SriranganS/Water-Surface-Trash-Collector/Pool Testing/Images/Isometric Angle.jpg

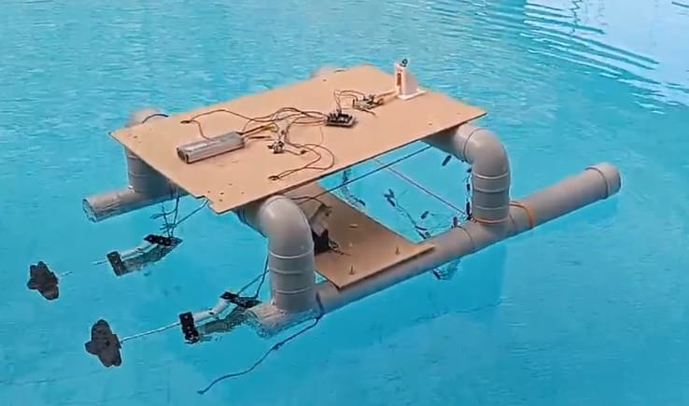
Pool Testing/Images/Isometric Angle.jpg
