SriranganS/Water-Surface-Trash-Collector/Pool Testing/Images/Floating.jpg

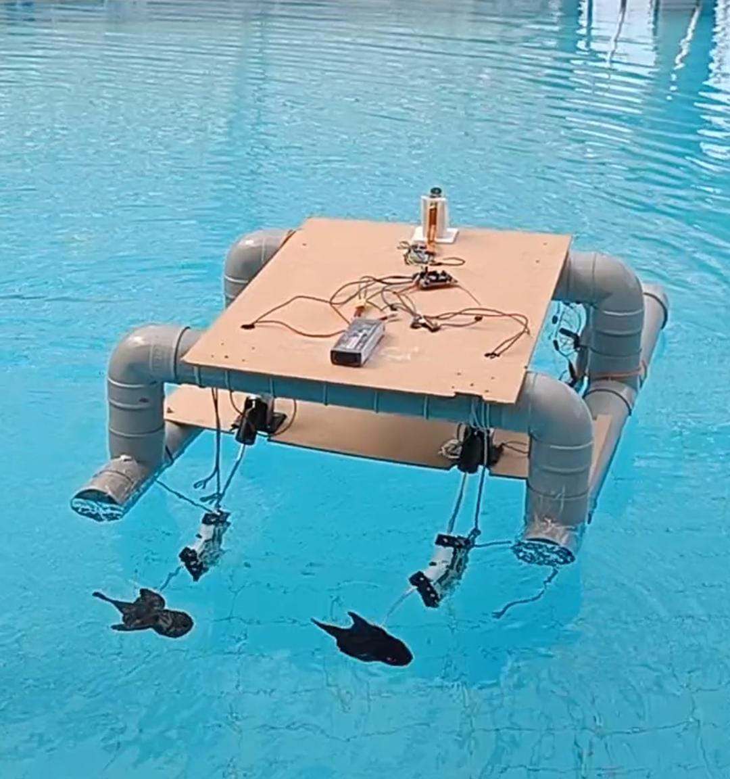
Pool Testing/Images/Floating.jpg
