SriranganS/Water-Surface-Trash-Collector/README.md

# Water-Surface-Trash-Collector
This project is part of the ES 408: Mechatronics course. Our objective is to make a boat with autonomous abilities that could be utilised to pick up trash floating in the water.
