SriranganS/Water-Surface-Trash-Collector/Presentation 1.pdf

# Water Surface Trash Collector

Hrishikesh Birje
Mihika Desai
Srirangan S

Mechanical Engineering
Indian Institute of Technology, Gandhinagar

# Problem

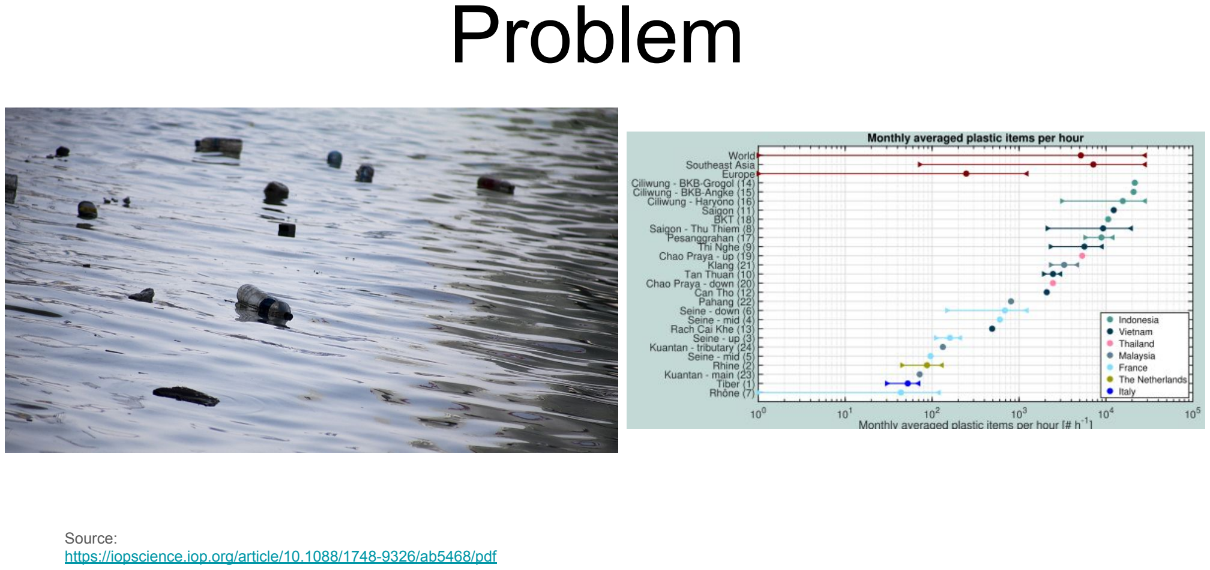
[picture p4: page 2]

8-10 metric tonnes enter the ocean every year.

Source:
https://iopscience.iop.org/article/10.1088/1748-9326/ab5468/pdf

## Design

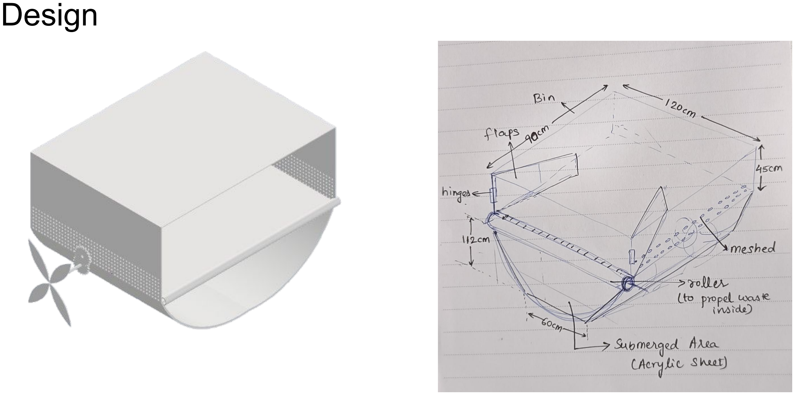
[picture p5: page 3]

## Details

- Material - Acrylic Sheet (density = 1180 kg/m3)
- Controller - Raspberry pi
- Assumed - Volume of Water displaced = 243 Litres
- We kept the height of the immersed area as a variable. On equating the Buoyant force with the Weight of the immersed body, we concluded the height to be 1.12 meters.
- Motors - 12V BLDC Motors
- Propellers (Diameter = 20 cm) - 500 rpm
- Gear - To elevate the motor altitude for waterproofing

## Electronic Circuitry

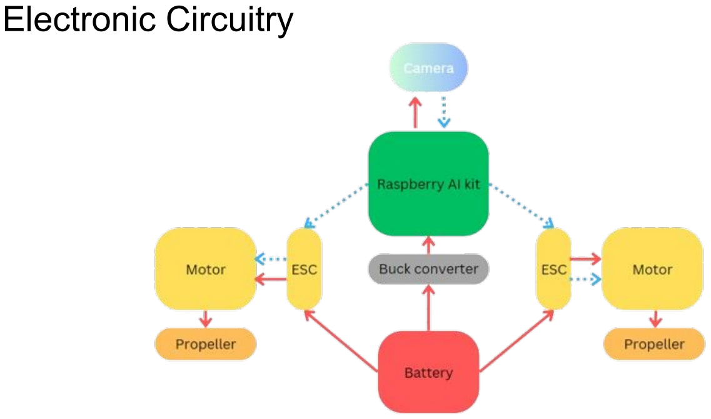
[picture p6: page 5]
