SriranganS/Water-Surface-Trash-Collector/Buoyancy Calculations for Design 2/Buoyancy Calculations 1.jpg

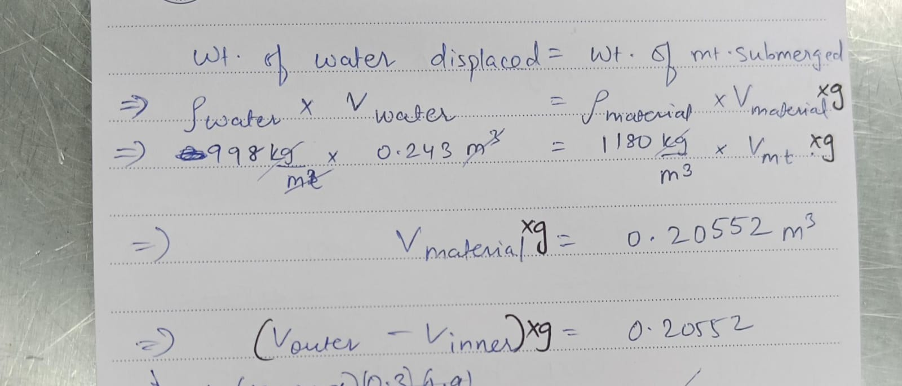
Buoyancy Calculations for Design 2/Buoyancy Calculations 1.jpg
