SriranganS/Water-Surface-Trash-Collector/Buoyancy Calculations for Design 2/Buoyancy Calculations 2.jpg

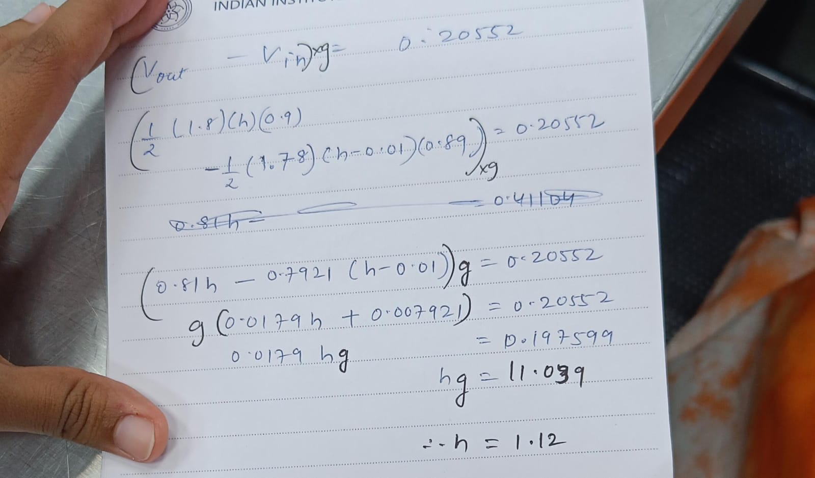
Buoyancy Calculations for Design 2/Buoyancy Calculations 2.jpg
