SriranganS/Water-Surface-Trash-Collector/MotorPropeller Connections/Images/Connection.jpg

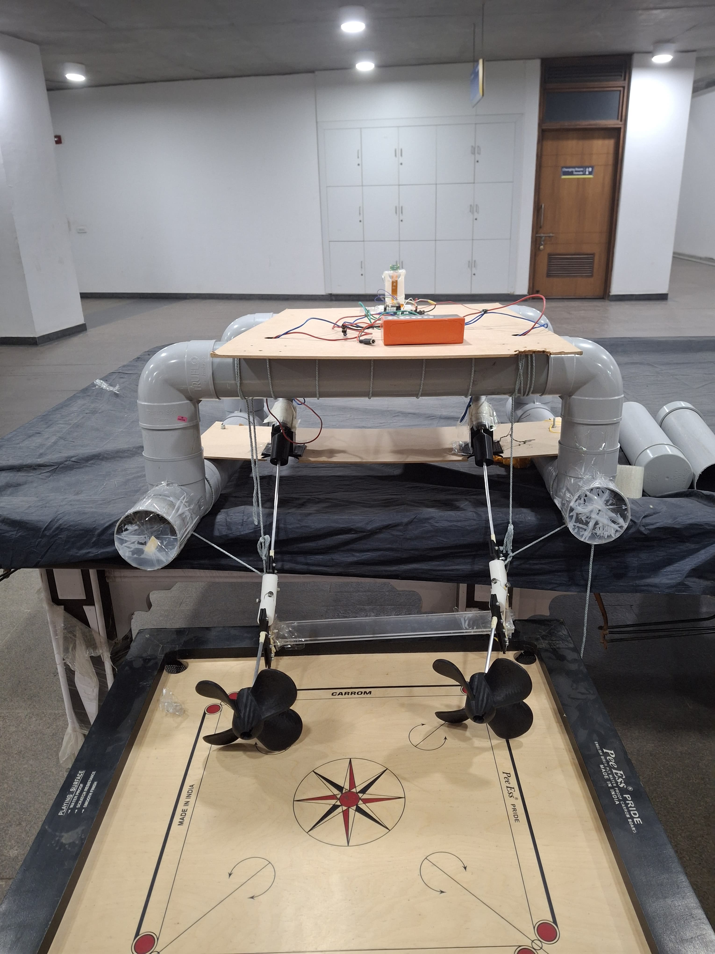
MotorPropeller Connections/Images/Connection.jpg
