SriranganS/Water-Surface-Trash-Collector/Updated Design/MainBody.SLDASM

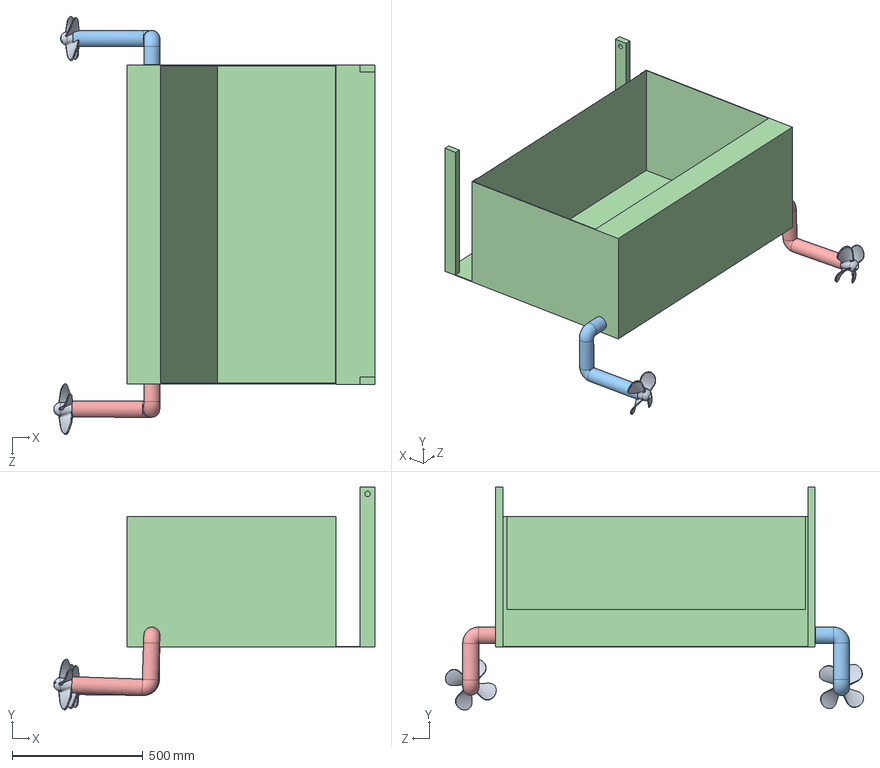
[picture p10: CAD file, 2024-10-14]
Updated Design/MainBody.SLDASM
1228.2 x 853.2 x 1600.4 mm
TubeRight
tefon dock
TubeLeft
Motor x 2
Prop 1 x 2
