SriranganS/Water-Surface-Trash-Collector/MotorPropeller Connections/CAD Models/U Joints/U Joint Attempts/Orient1.SLDASM

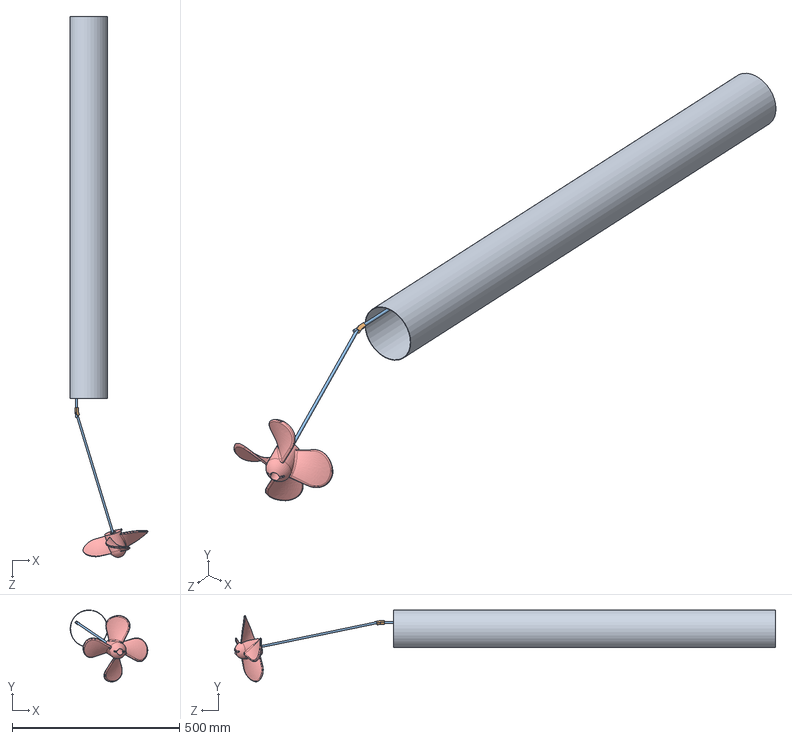
[picture p11: CAD file, 2024-11-22]
MotorPropeller Connections/CAD Models/U Joints/U Joint Attempts/Orient1.SLDASM
232.3 x 215.2 x 1619.7 mm
Prop 1
PropClos
Shaf x 2
Ujoint
Pip
