SriranganS/Water-Surface-Trash-Collector/Updated Design/Conveyer Belt.SLDASM

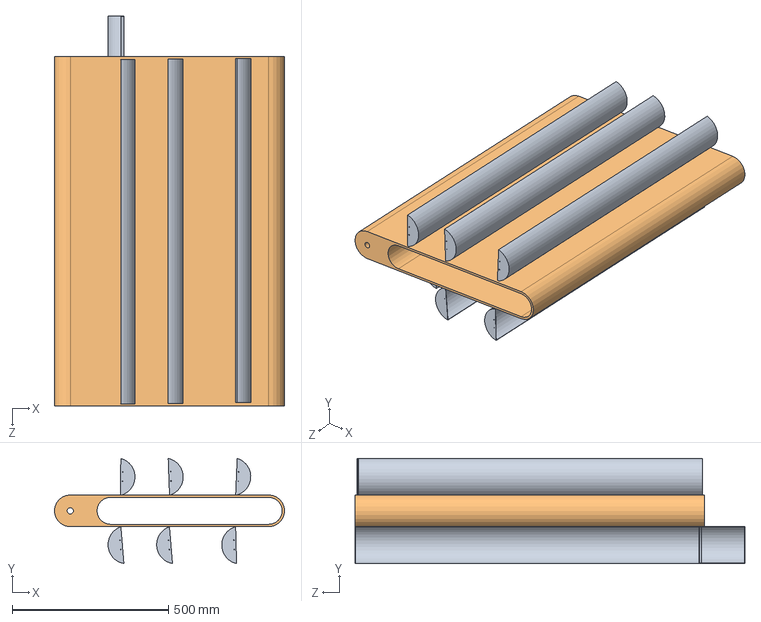
[picture p12: CAD file, 2024-10-14]
Updated Design/Conveyer Belt.SLDASM
736.6 x 337.0 x 1248.0 mm
belt
blade 300mm x 6
