SriranganS/Water-Surface-Trash-Collector/CAD Model for Final Prototype/MainBody.SLDASM

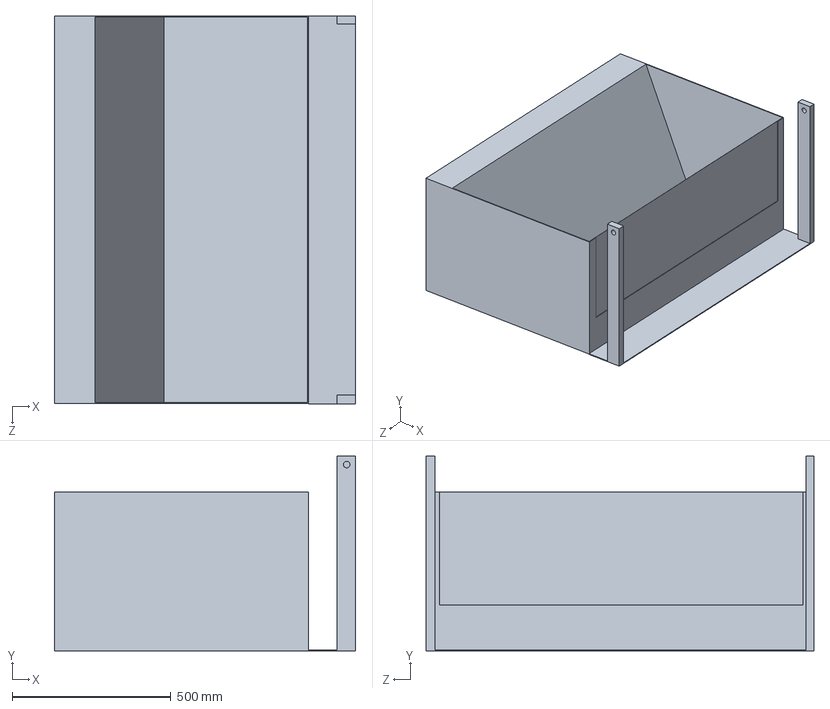
[picture p13: CAD file, 2024-11-22]
CAD Model for Final Prototype/MainBody.SLDASM
948.3 x 612.6 x 1221.2 mm
