SriranganS/Water-Surface-Trash-Collector/MotorPropeller Connections/CAD Models/U Joints/U Joint Attempts/ASSY_BERG_UJ3_U-JOINT_0250 SHAFT.sldasm

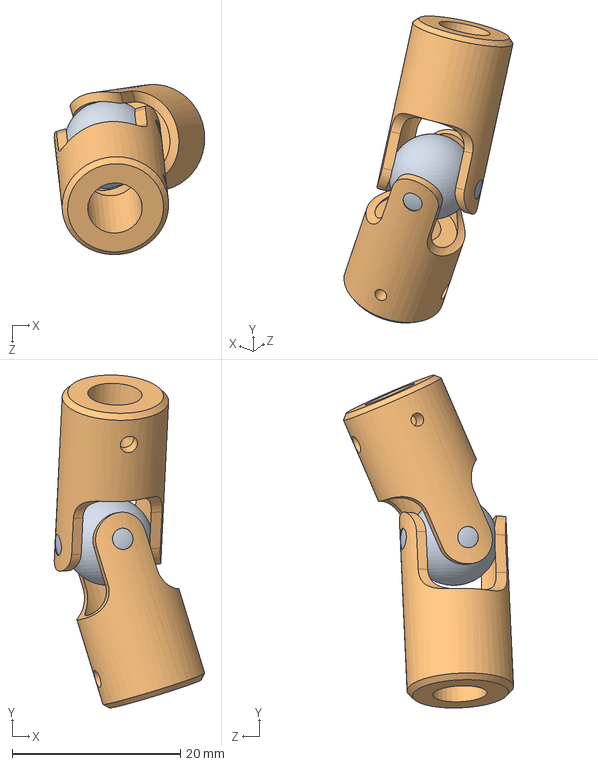
[picture p14: CAD file, 2024-11-22]
MotorPropeller Connections/CAD Models/U Joints/U Joint Attempts/ASSY_BERG_UJ3_U-JOINT_0250 SHAFT.sldasm
17.9 x 39.6 x 20.3 mm
UJ-3_YOKE x 2
UJ-3_BALL
