SriranganS/Water-Surface-Trash-Collector/Updated Design/FinalAssembly.SLDASM

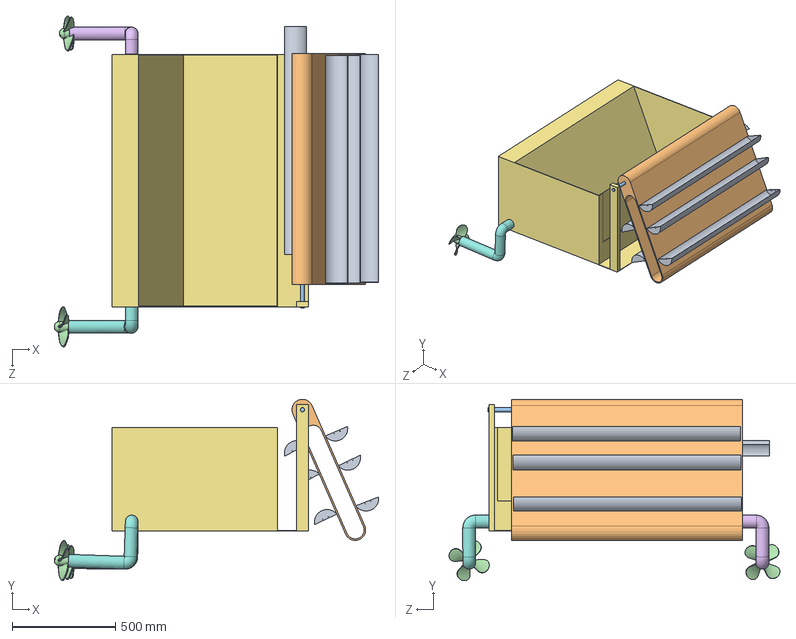
[picture p15: CAD file, 2024-10-14]
Updated Design/FinalAssembly.SLDASM
1568.6 x 877.3 x 1600.4 mm
TubeRight
tefon dock
TubeLeft
Motor x 2
Prop 1 x 2
Shaft
belt
blade 300mm x 6
