SriranganS/Water-Surface-Trash-Collector/CAD Model for Final Prototype/PresentCAD.SLDASM

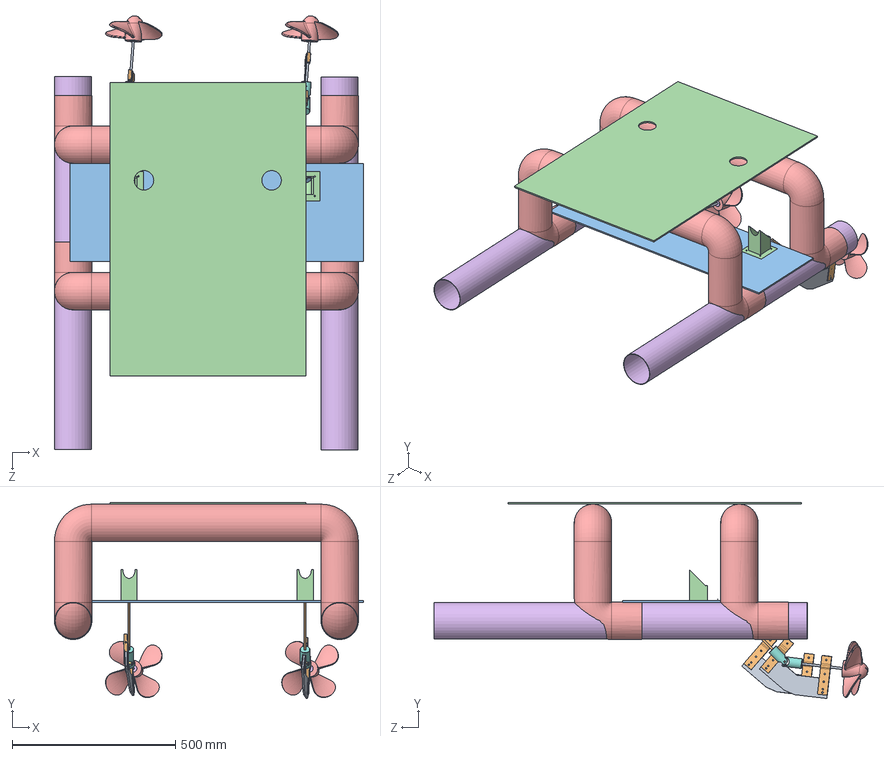
[picture p16: CAD file, 2024-11-22]
CAD Model for Final Prototype/PresentCAD.SLDASM
947.6 x 600.9 x 1330.0 mm
BottomPipe x 2
RectPipe x 2
MDF
LowerMDF
ShaftLong x 2
ShaftShort x 2
Joint B x 4
Plus x 2
PropClos x 2
Prop 1 x 2
mountmotor x 2
motormount_part2 x 2
shaft_angle_fixer x 8
plat2 x 2
