SriranganS/Water-Surface-Trash-Collector/CAD Model for Final Prototype/ShaftFix.SLDASM

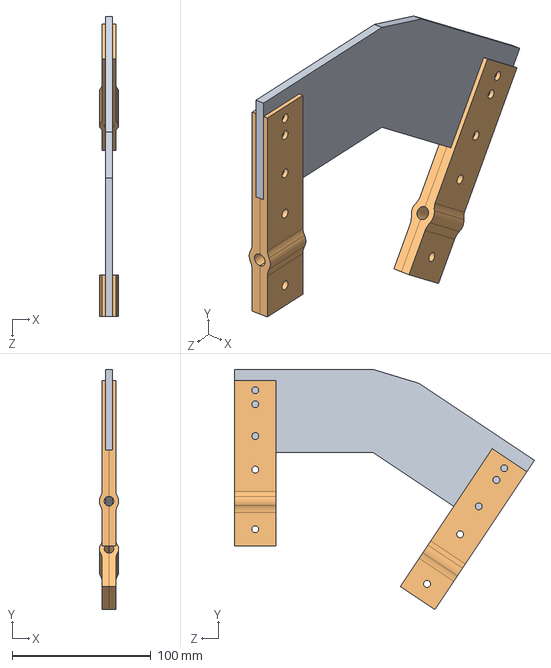
[picture p17: CAD file, 2024-11-22]
CAD Model for Final Prototype/ShaftFix.SLDASM
13.9 x 173.3 x 216.5 mm
shaft_angle_fixer x 4
plat2
