SriranganS/Water-Surface-Trash-Collector/CAD Model for Final Prototype/mountmotor_assembly.SLDASM

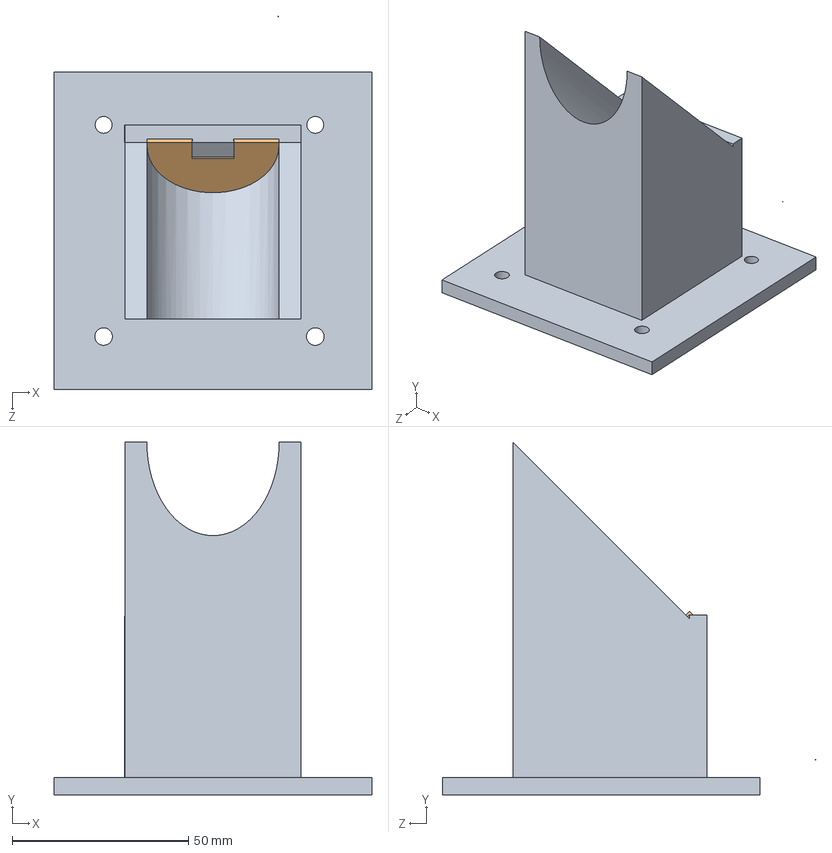
[picture p18: CAD file, 2024-11-22]
CAD Model for Final Prototype/mountmotor_assembly.SLDASM
90.0 x 100.0 x 105.7 mm
motormount_part2
mountmotor
