SriranganS/Water-Surface-Trash-Collector/CAD Model for Final Prototype/BottomPipe.SLDPRT

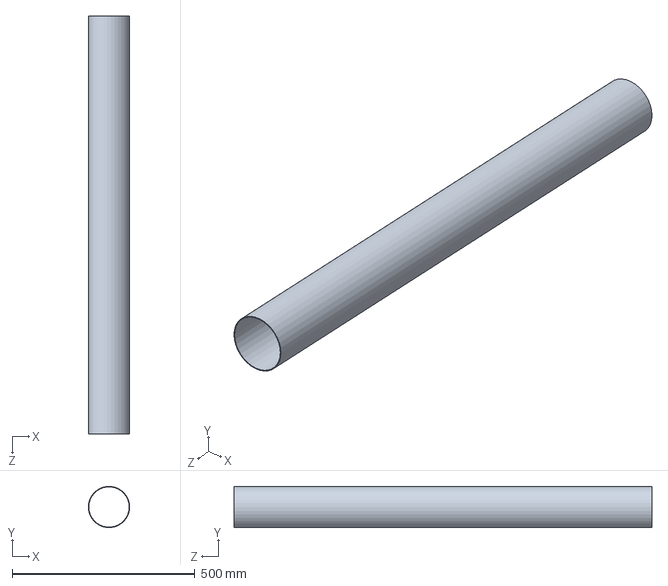
[picture p19: CAD file, 2024-11-22]
CAD Model for Final Prototype/BottomPipe.SLDPRT
113.0 x 112.5 x 1143.0 mm
