SriranganS/Water-Surface-Trash-Collector/MotorPropeller Connections/CAD Models/Assembly/ShaftShort.SLDPRT

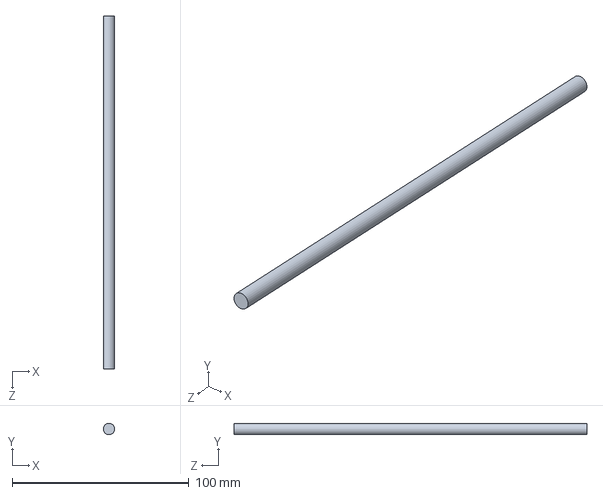
[picture p20: CAD file, 2024-11-22]
MotorPropeller Connections/CAD Models/Assembly/ShaftShort.SLDPRT
6.50 x 6.49 x 200.0 mm
