SriranganS/Water-Surface-Trash-Collector/MotorPropeller Connections/CAD Models/Coupler Attempts/DoubCoup.STL

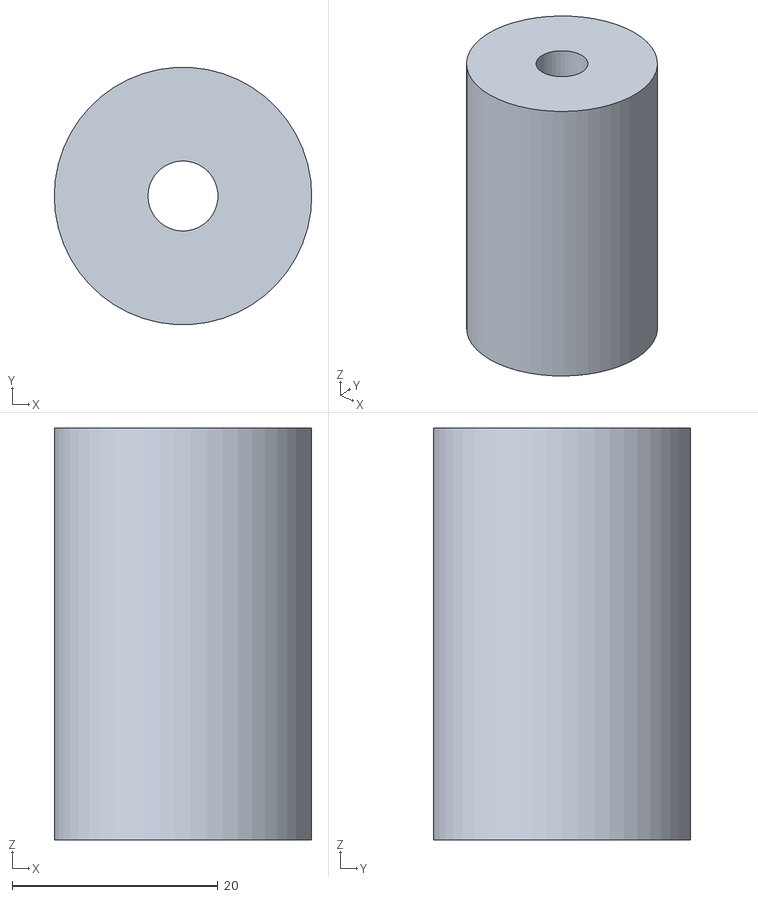
[picture p21: CAD file, 2024-11-22]
MotorPropeller Connections/CAD Models/Coupler Attempts/DoubCoup.STL
25.0 x 25.0 x 40.0
