SriranganS/Water-Surface-Trash-Collector/MotorPropeller Connections/CAD Models/MotorMount/motormount_part2.STL

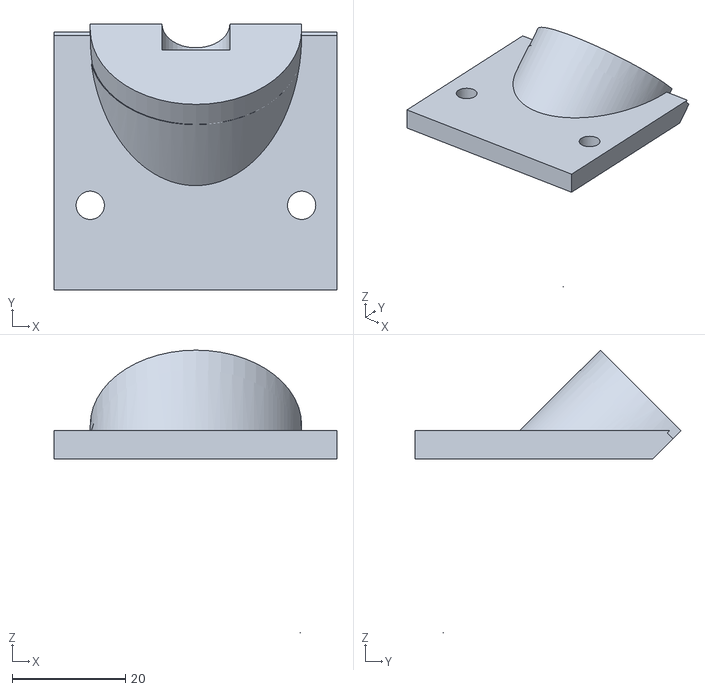
[picture p22: CAD file, 2024-11-22]
MotorPropeller Connections/CAD Models/MotorMount/motormount_part2.STL
50.0 x 47.1 x 50.0
