SriranganS/Water-Surface-Trash-Collector/MotorPropeller Connections/CAD Models/U Joints/U Joint Attempts/UJ-3_YOKE.sldprt

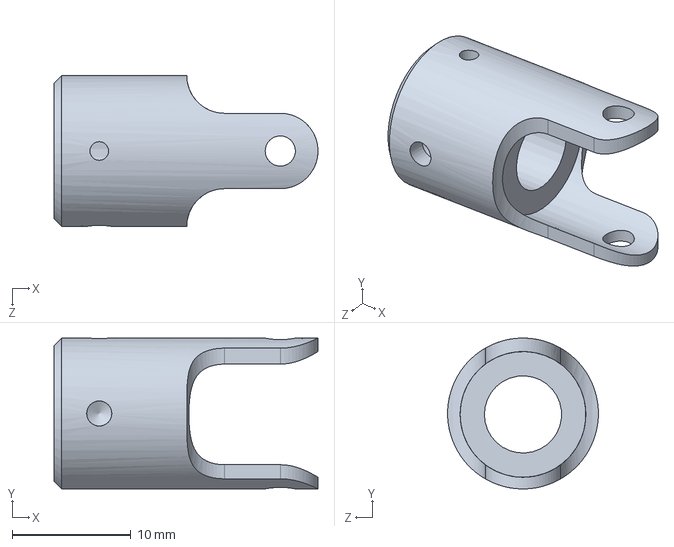
[picture p23: CAD file, 2024-11-22]
MotorPropeller Connections/CAD Models/U Joints/U Joint Attempts/UJ-3_YOKE.sldprt
22.2 x 12.7 x 12.7 mm
