SriranganS/Water-Surface-Trash-Collector/MotorPropeller Connections/CAD Models/U Joints/U Joint Final/Plus.SLDPRT

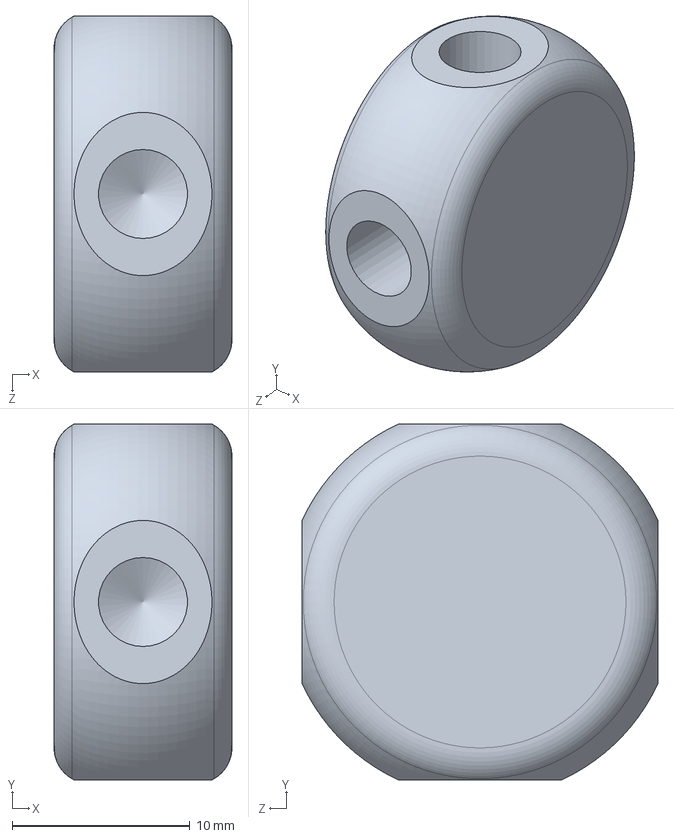
[picture p24: CAD file, 2024-11-22]
MotorPropeller Connections/CAD Models/U Joints/U Joint Final/Plus.SLDPRT
10.0 x 20.0 x 20.0 mm
