SriranganS/Water-Surface-Trash-Collector/U Joint Stabilisation/CAD/Catch.DXF

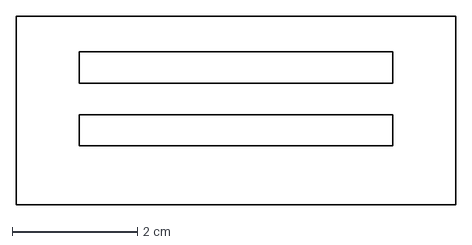
[picture p25: CAD file, 2024-11-22]
U Joint Stabilisation/CAD/Catch.DXF
7.00 x 3.00 cm
