SriranganS/Water-Surface-Trash-Collector/Updated Design/TubeLeft.SLDPRT

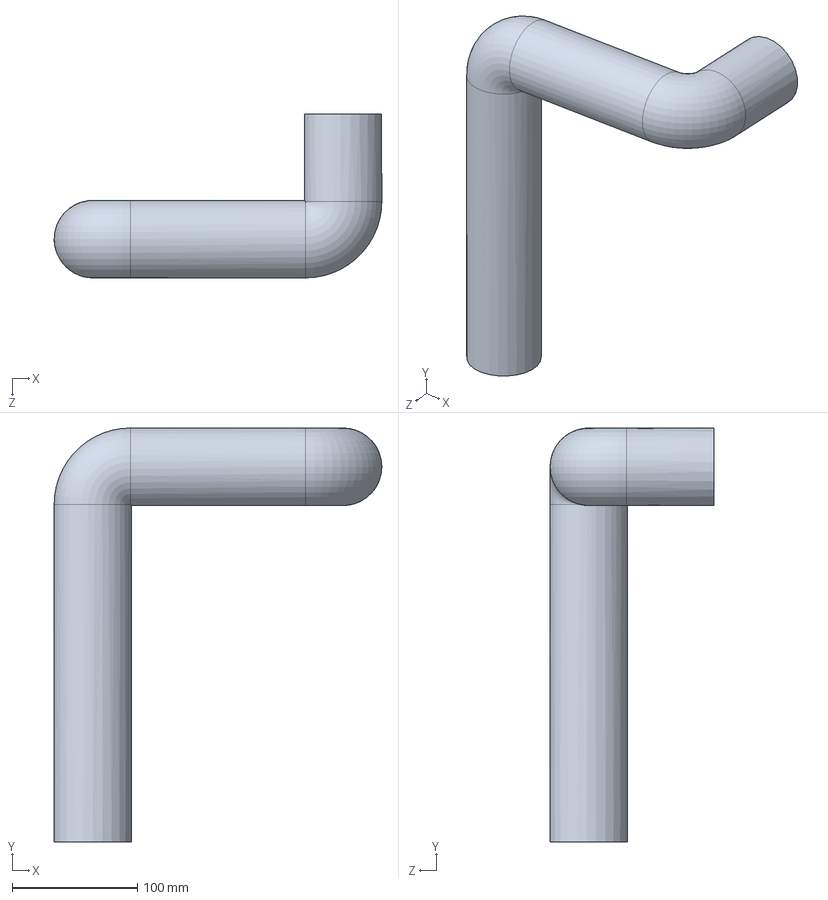
[picture p26: CAD file, 2024-10-14]
Updated Design/TubeLeft.SLDPRT
262.0 x 331.0 x 131.0 mm
