SriranganS/Water-Surface-Trash-Collector/Waterproofing - Universal Joints/CAD/UJointcover.STL

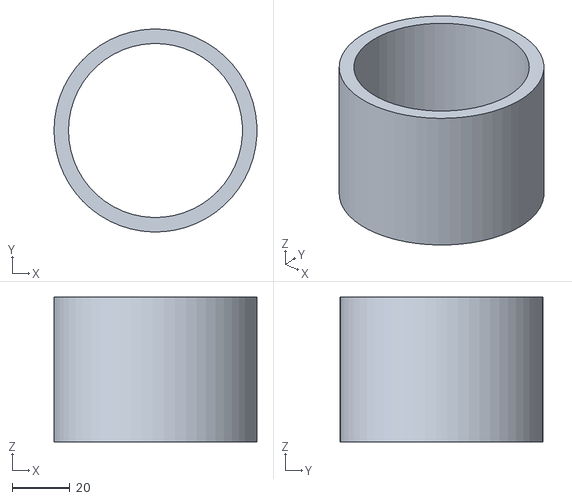
[picture p27: CAD file, 2024-11-22]
Waterproofing - Universal Joints/CAD/UJointcover.STL
70.0 x 70.0 x 50.0
