SriranganS/Water-Surface-Trash-Collector/Waterproofing Mechanism 1/LStand.STL

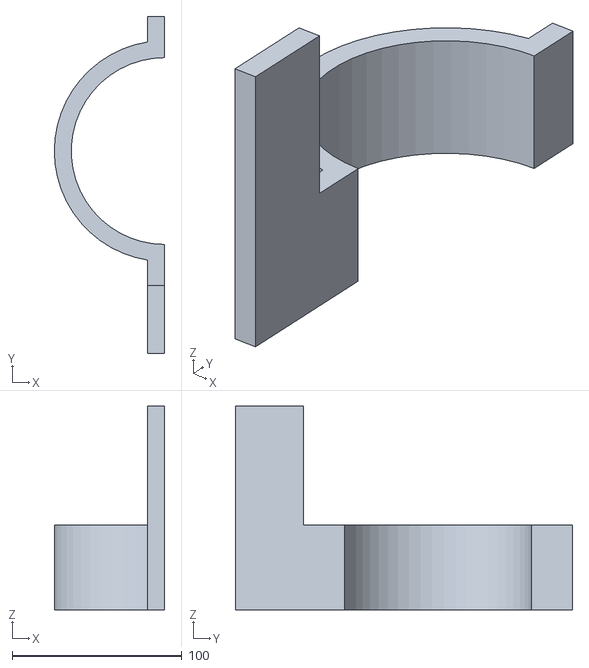
[picture p28: CAD file, 2024-11-22]
Waterproofing Mechanism 1/LStand.STL
65.0 x 198.5 x 120.0
