SriranganS/Water-Surface-Trash-Collector/CAD Model for Final Prototype/MDF.SLDPRT

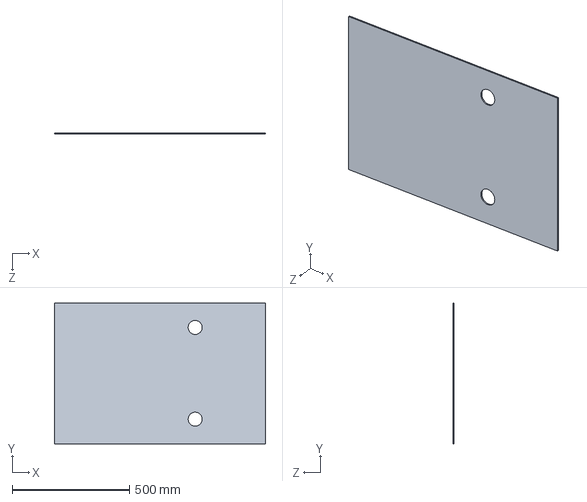
[picture p29: CAD file, 2024-11-22]
CAD Model for Final Prototype/MDF.SLDPRT
900.0 x 600.0 x 5.00 mm
