SriranganS/Water-Surface-Trash-Collector/MotorPropeller Connections/CAD Models/Assembly/ShaftLong.SLDPRT

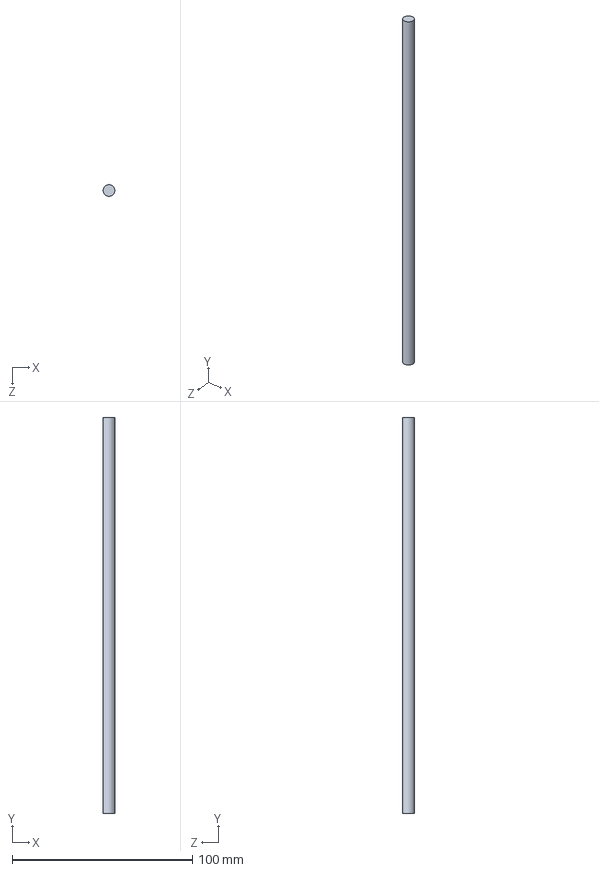
[picture p30: CAD file, 2024-11-22]
MotorPropeller Connections/CAD Models/Assembly/ShaftLong.SLDPRT
6.45 x 220.0 x 6.50 mm
