SriranganS/Water-Surface-Trash-Collector/MotorPropeller Connections/CAD Models/Coupler Attempts/SelfMadeCoupler.STL

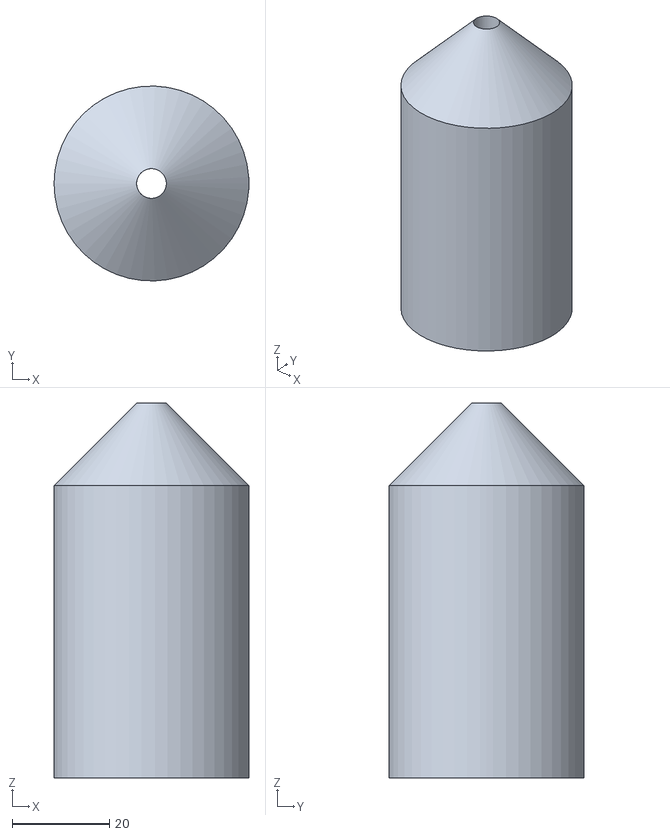
[picture p31: CAD file, 2024-11-22]
MotorPropeller Connections/CAD Models/Coupler Attempts/SelfMadeCoupler.STL
40.0 x 40.0 x 76.9
