SriranganS/Water-Surface-Trash-Collector/MotorPropeller Connections/CAD Models/MotorMount/mountmotor_new.STL

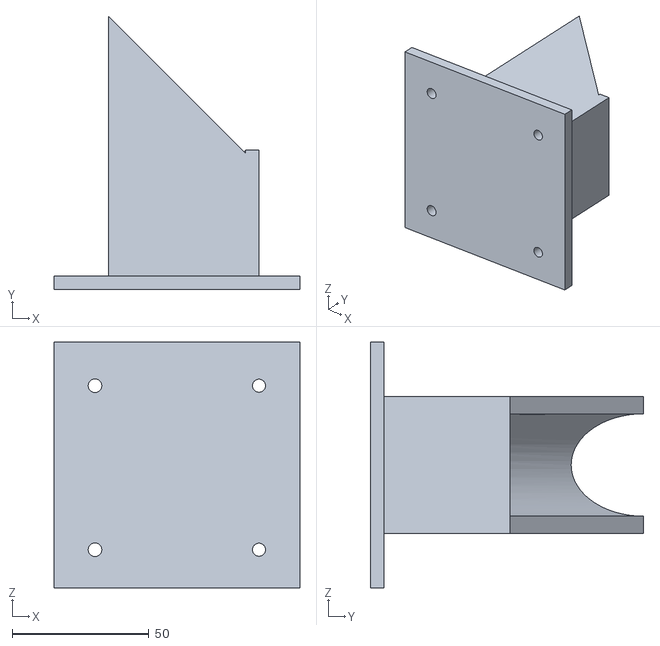
[picture p32: CAD file, 2024-11-22]
MotorPropeller Connections/CAD Models/MotorMount/mountmotor_new.STL
90.0 x 100.0 x 90.0
