SriranganS/Water-Surface-Trash-Collector/MotorPropeller Connections/CAD Models/U Joints/U Joint Attempts/Shaf.SLDPRT

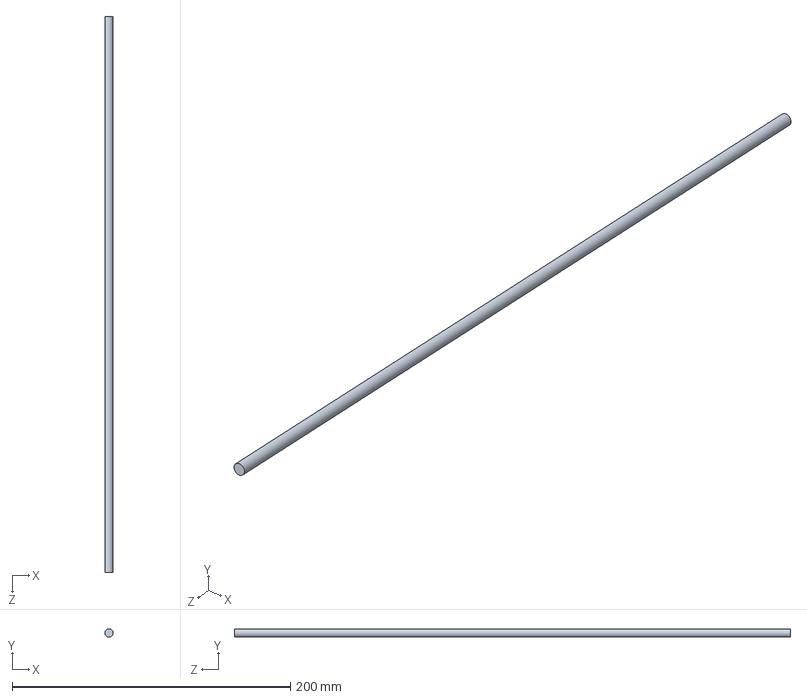
[picture p33: CAD file, 2024-11-22]
MotorPropeller Connections/CAD Models/U Joints/U Joint Attempts/Shaf.SLDPRT
6.00 x 6.00 x 400.0 mm
