SriranganS/Water-Surface-Trash-Collector/MotorPropeller Connections/CAD Models/U Joints/U Joint Final/Joint B.SLDPRT

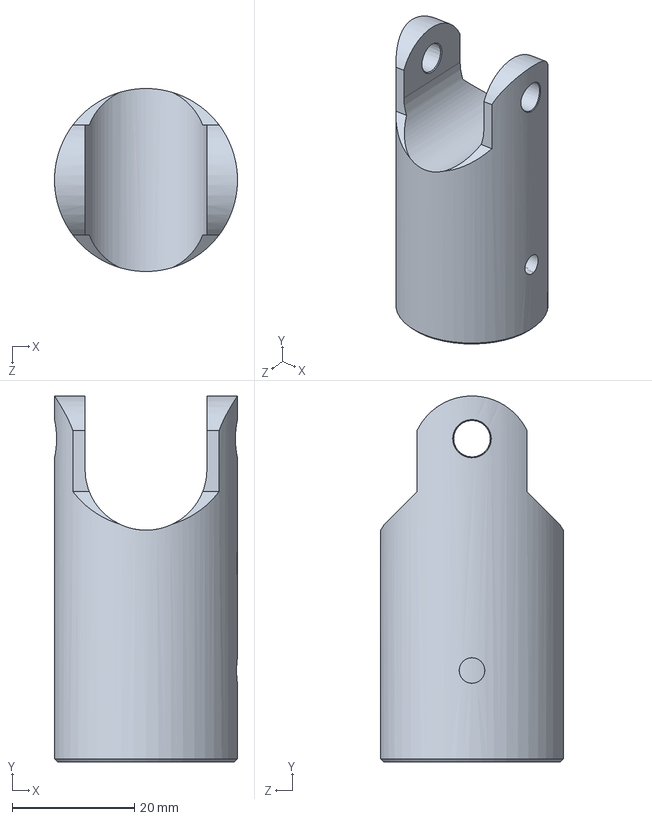
[picture p34: CAD file, 2024-11-22]
MotorPropeller Connections/CAD Models/U Joints/U Joint Final/Joint B.SLDPRT
30.0 x 60.0 x 30.0 mm
