SriranganS/Water-Surface-Trash-Collector/CAD Model for Final Prototype/Battery - Copy.SLDPRT

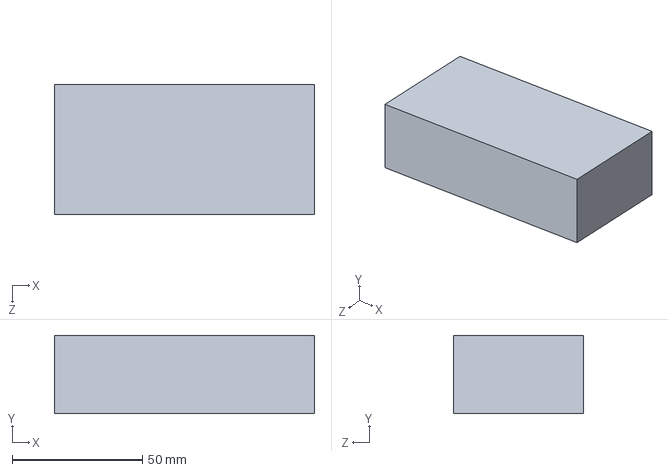
[picture p35: CAD file, 2024-11-22]
CAD Model for Final Prototype/Battery - Copy.SLDPRT
100.0 x 30.0 x 50.0 mm
