SriranganS/Water-Surface-Trash-Collector/MotorPropeller Connections/CAD Models/Coupler Attempts/flex coupler.STL

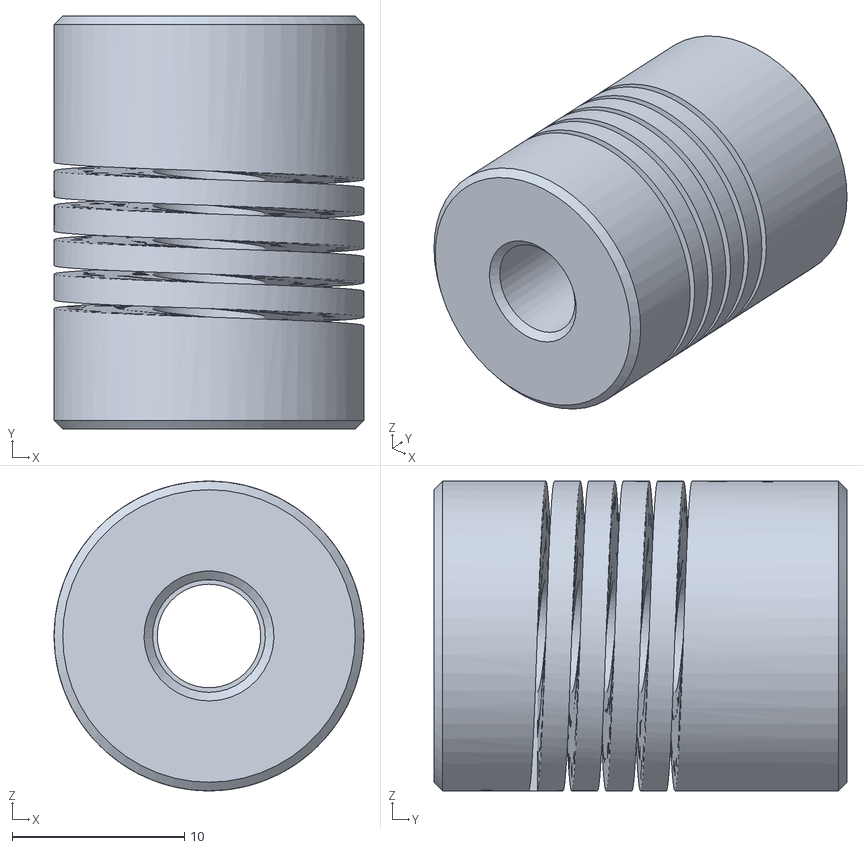
[picture p36: CAD file, 2024-11-22]
MotorPropeller Connections/CAD Models/Coupler Attempts/flex coupler.STL
18.0 x 24.0 x 18.0
