SriranganS/Water-Surface-Trash-Collector/Waterproofing Mechanism 1/gear.SLDPRT

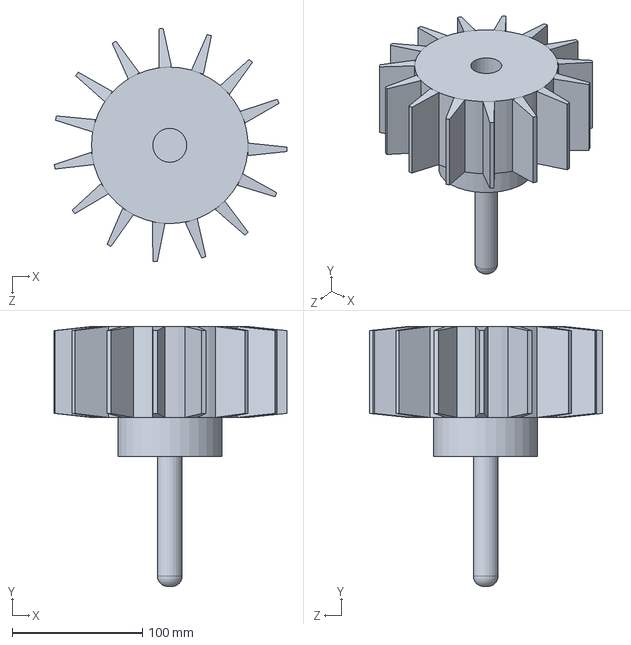
[picture p37: CAD file, 2024-11-22]
Waterproofing Mechanism 1/gear.SLDPRT
178.9 x 200.0 x 179.5 mm
