SriranganS/Water-Surface-Trash-Collector/CAD Model for Final Prototype/platf2.DXF

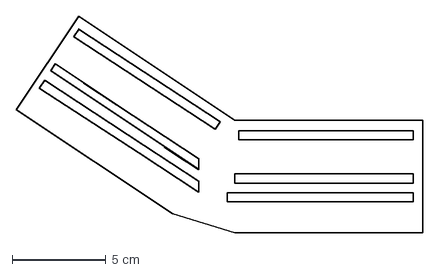
[picture p38: CAD file, 2024-11-22]
CAD Model for Final Prototype/platf2.DXF
21.6 x 11.5 cm
