SriranganS/Water-Surface-Trash-Collector/MotorPropeller Connections/CAD Models/Coupler Attempts/Shaft Coupler.STL

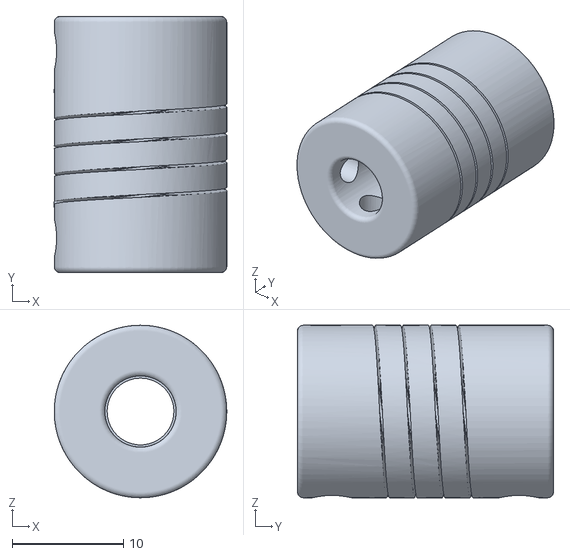
[picture p39: CAD file, 2024-11-22]
MotorPropeller Connections/CAD Models/Coupler Attempts/Shaft Coupler.STL
15.5 x 23.0 x 15.5
