SriranganS/Water-Surface-Trash-Collector/Waterproofing Mechanism 1/gearupper.SLDPRT

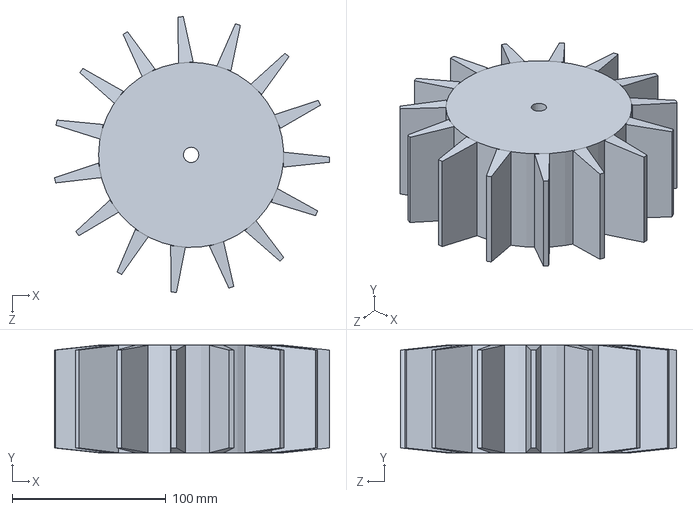
[picture p40: CAD file, 2024-11-22]
Waterproofing Mechanism 1/gearupper.SLDPRT
178.9 x 70.0 x 179.5 mm
