SriranganS/Water-Surface-Trash-Collector/CAD Model for Final Prototype/RectPipe.SLDPRT

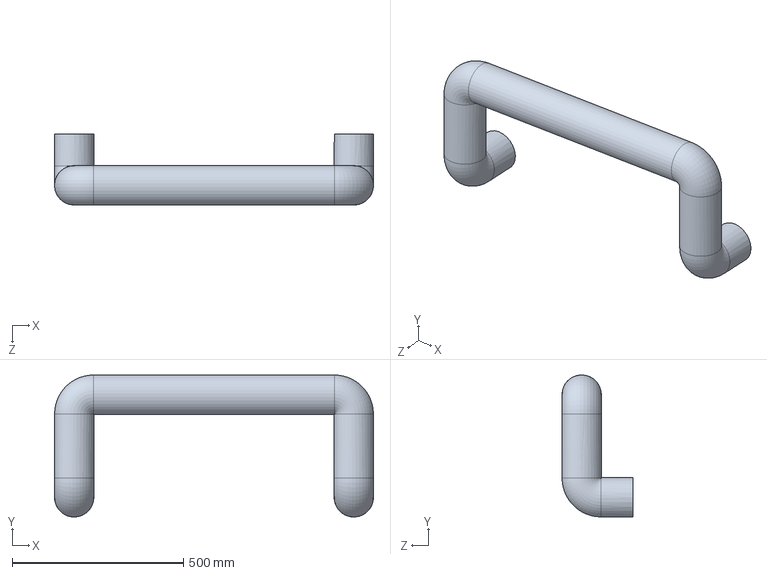
[picture p41: CAD file, 2024-11-22]
CAD Model for Final Prototype/RectPipe.SLDPRT
931.7 x 414.7 x 207.4 mm
