SriranganS/Water-Surface-Trash-Collector/MotorPropeller Connections/CAD Models/Coupler Attempts/NEMA17_Coupler.STL

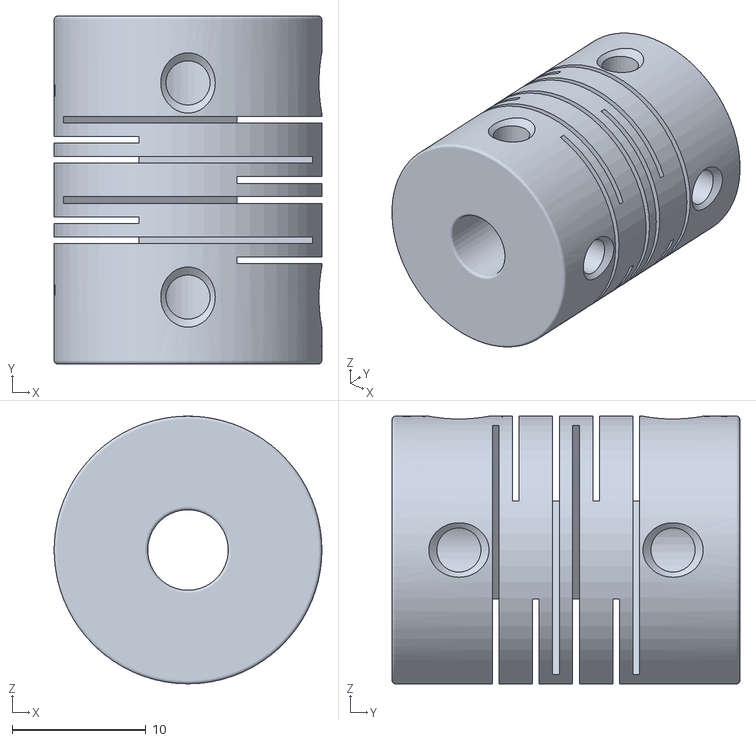
[picture p42: CAD file, 2024-11-22]
MotorPropeller Connections/CAD Models/Coupler Attempts/NEMA17_Coupler.STL
20.0 x 26.0 x 20.0
