SriranganS/Water-Surface-Trash-Collector/MotorPropeller Connections/CAD Models/U Joints/U Joint Attempts/UJ-3_BALL.sldprt

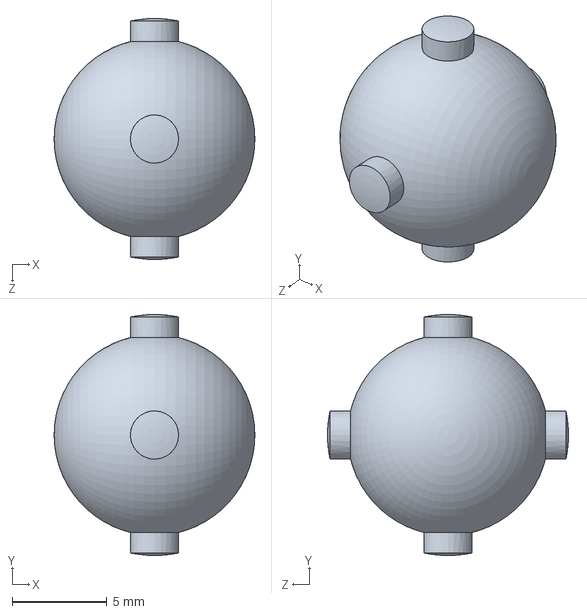
[picture p43: CAD file, 2024-11-22]
MotorPropeller Connections/CAD Models/U Joints/U Joint Attempts/UJ-3_BALL.sldprt
10.6 x 12.7 x 12.7 mm
