SriranganS/Water-Surface-Trash-Collector/MotorPropeller Connections/CAD Models/U Joints/U Joint Attempts/Ujoint.SLDPRT

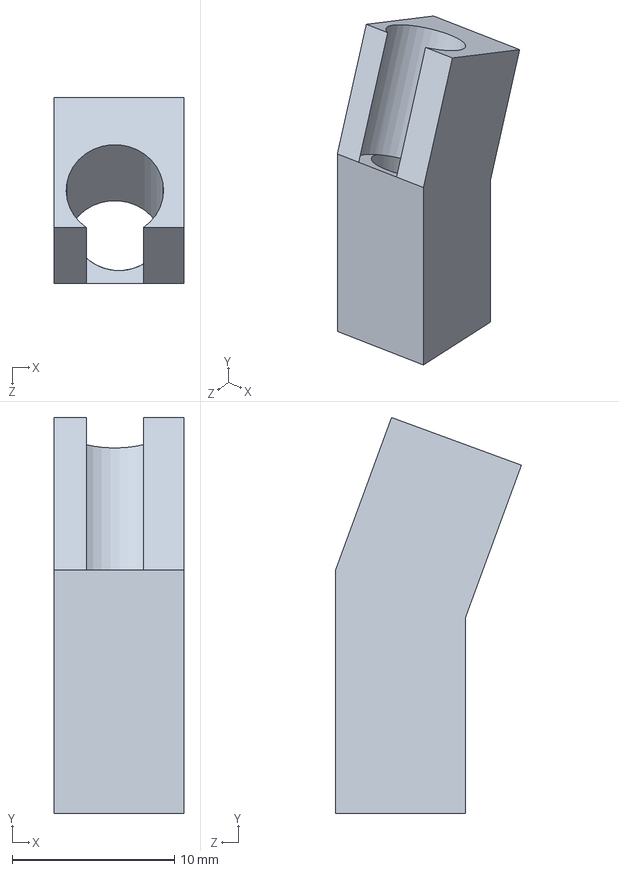
[picture p44: CAD file, 2024-11-22]
MotorPropeller Connections/CAD Models/U Joints/U Joint Attempts/Ujoint.SLDPRT
8.00 x 24.4 x 11.4 mm
