SriranganS/Water-Surface-Trash-Collector/Updated Design/Prop 1.SLDPRT

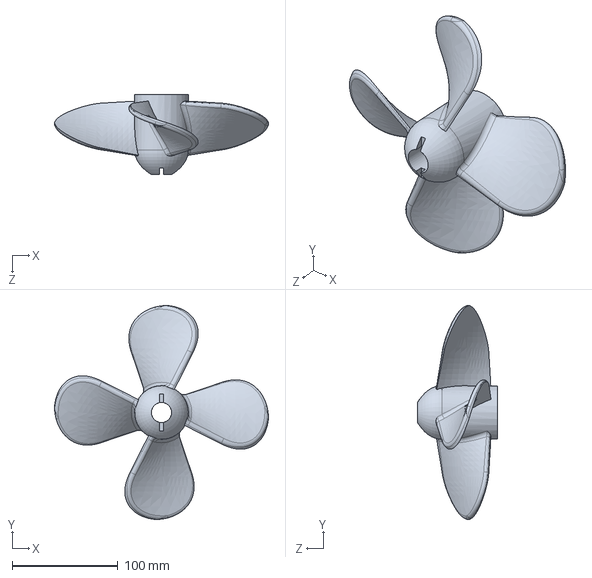
[picture p45: CAD file, 2024-10-14]
Updated Design/Prop 1.SLDPRT
202.8 x 202.8 x 76.2 mm
