SriranganS/Water-Surface-Trash-Collector/Updated Design/Shaft.SLDPRT

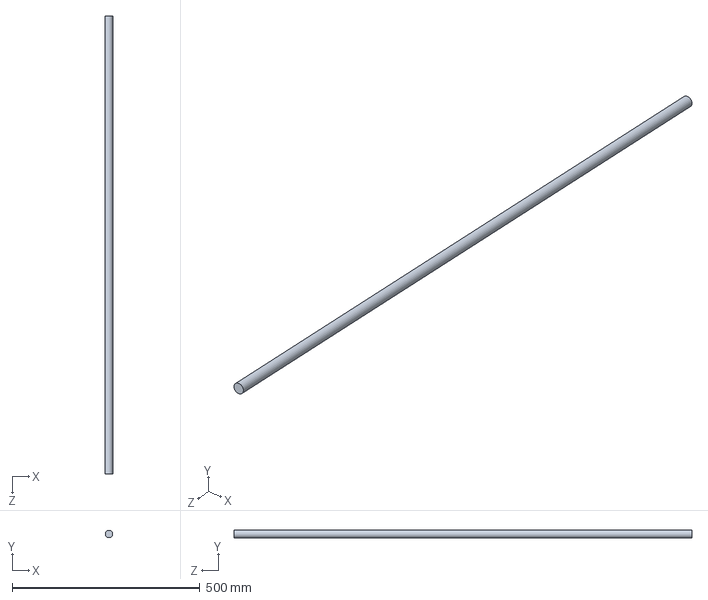
[picture p46: CAD file, 2024-10-14]
Updated Design/Shaft.SLDPRT
20.0 x 20.0 x 1219.2 mm
