SriranganS/Water-Surface-Trash-Collector/CAD Model for Final Prototype/LowerMDF.SLDPRT

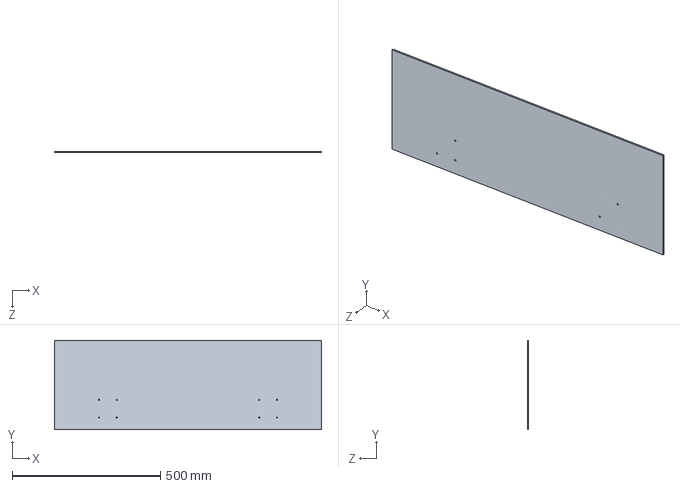
[picture p47: CAD file, 2024-11-22]
CAD Model for Final Prototype/LowerMDF.SLDPRT
900.0 x 300.0 x 5.00 mm
