SriranganS/Water-Surface-Trash-Collector/Updated Design/belt.SLDPRT

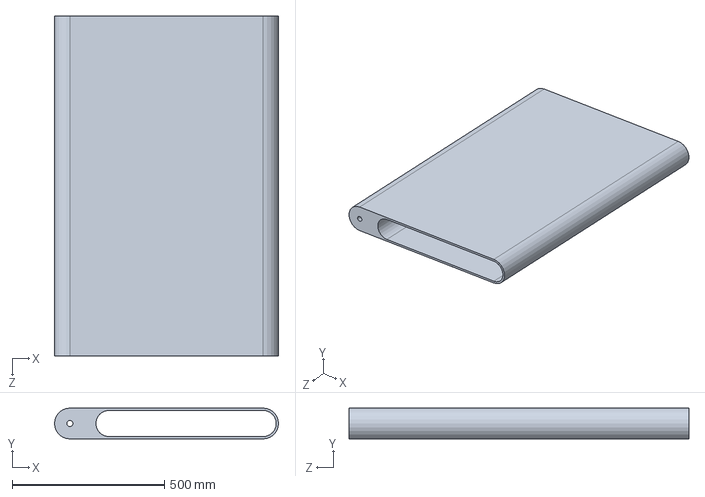
[picture p48: CAD file, 2024-10-14]
Updated Design/belt.SLDPRT
736.6 x 101.6 x 1117.6 mm
