SriranganS/Water-Surface-Trash-Collector/Updated Design/blade 300mm.SLDPRT

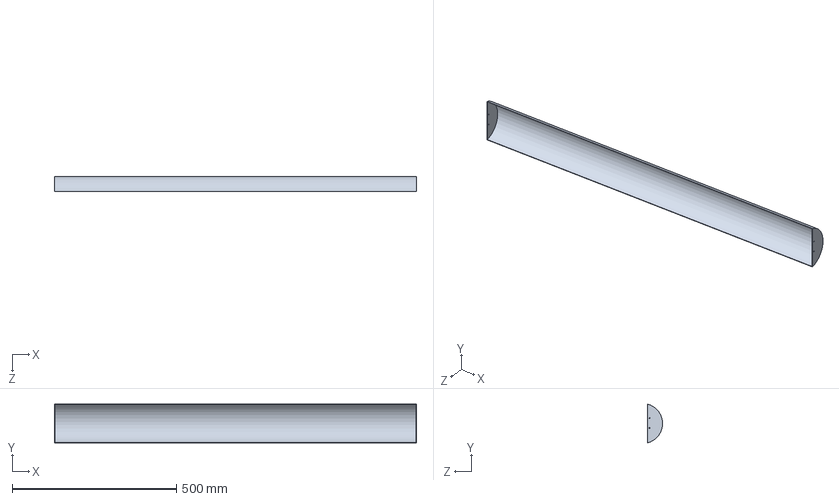
[picture p49: CAD file, 2024-10-14]
Updated Design/blade 300mm.SLDPRT
1102.0 x 118.3 x 45.8 mm
