SriranganS/Water-Surface-Trash-Collector/CAD Model for Final Prototype/plat2.SLDPRT

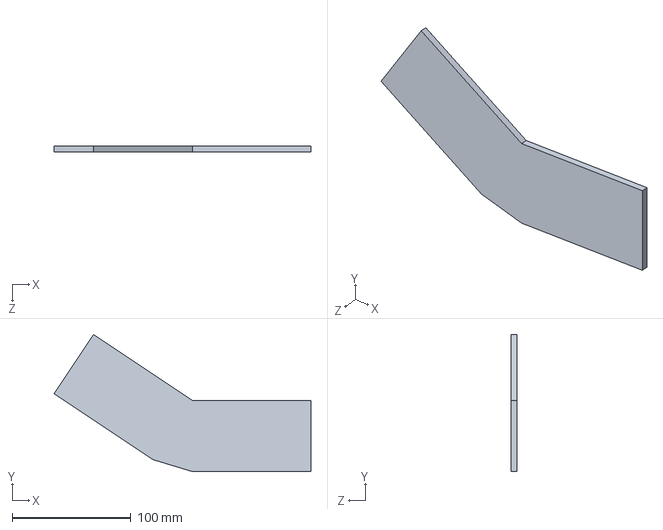
[picture p50: CAD file, 2024-11-22]
CAD Model for Final Prototype/plat2.SLDPRT
216.5 x 115.5 x 5.00 mm
