SriranganS/Water-Surface-Trash-Collector/CAD Model for Final Prototype/BackSeal - Copy.SLDPRT

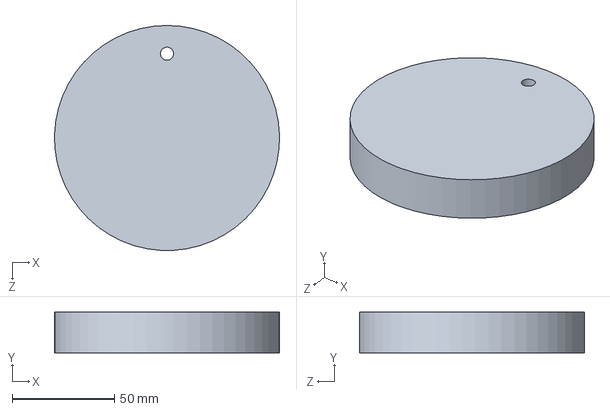
[picture p51: CAD file, 2024-11-22]
CAD Model for Final Prototype/BackSeal - Copy.SLDPRT
110.0 x 20.0 x 110.0 mm
