SriranganS/Water-Surface-Trash-Collector/CAD Model for Final Prototype/CameraMount.SLDPRT

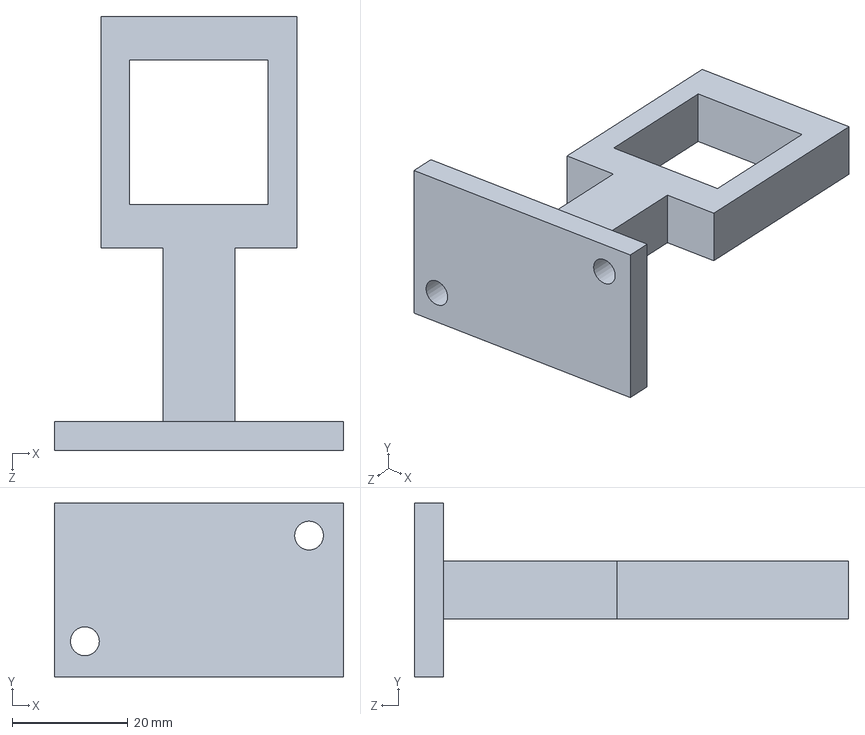
[picture p52: CAD file, 2024-11-22]
CAD Model for Final Prototype/CameraMount.SLDPRT
50.0 x 30.0 x 75.0 mm
