SriranganS/Water-Surface-Trash-Collector/CAD Model for Final Prototype/PropClos.SLDPRT

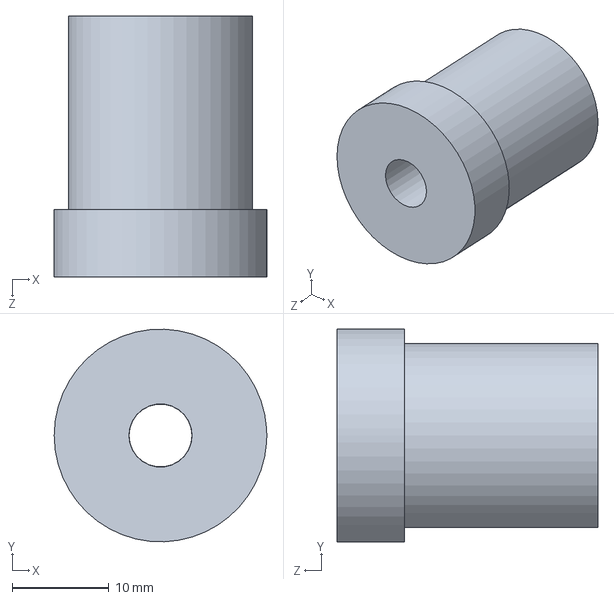
[picture p53: CAD file, 2024-11-22]
CAD Model for Final Prototype/PropClos.SLDPRT
22.0 x 22.0 x 27.0 mm
