SriranganS/Water-Surface-Trash-Collector/CAD Model for Final Prototype/shaft_angle_fixer.SLDPRT

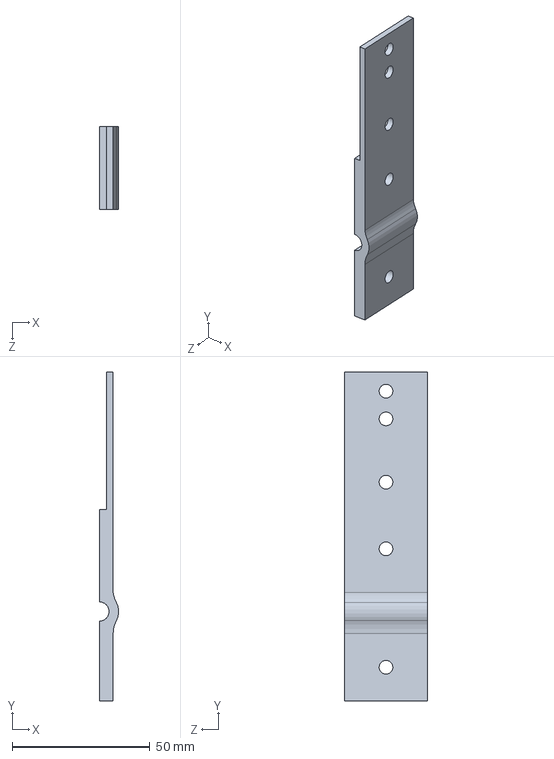
[picture p54: CAD file, 2024-11-22]
CAD Model for Final Prototype/shaft_angle_fixer.SLDPRT
6.97 x 119.5 x 30.0 mm
