SriranganS/Water-Surface-Trash-Collector/CAD Model for Final Prototype/Throw.SLDPRT

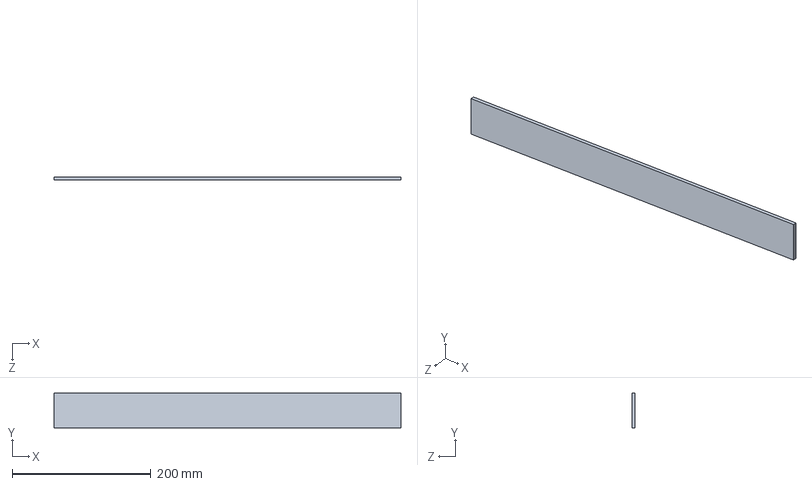
[picture p55: CAD file, 2024-11-22]
CAD Model for Final Prototype/Throw.SLDPRT
500.0 x 50.0 x 5.00 mm
