SriranganS/Water-Surface-Trash-Collector/CAD Model for Final Prototype/Motor.SLDPRT

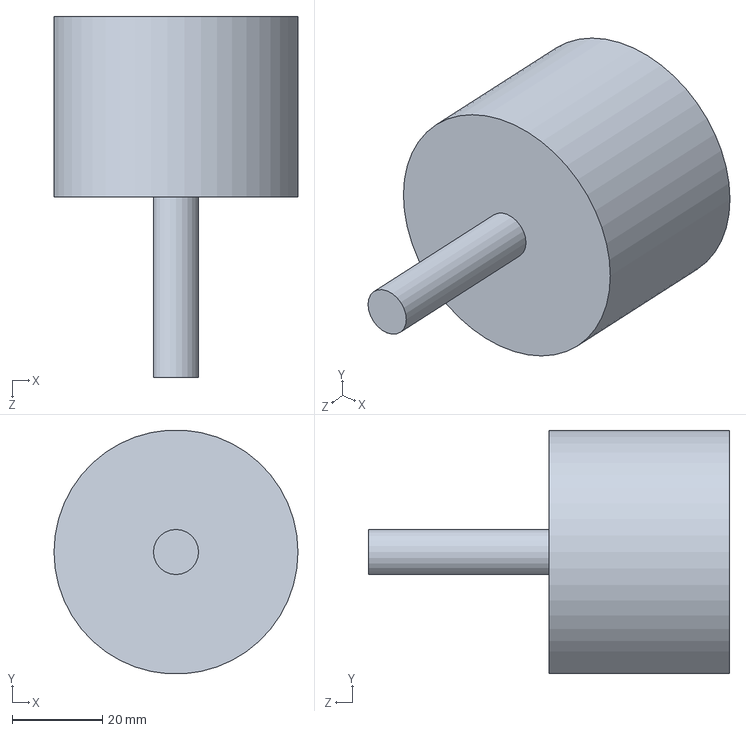
[picture p56: CAD file, 2024-10-14]
CAD Model for Final Prototype/Motor.SLDPRT
54.0 x 53.9 x 80.0 mm
