SriranganS/Water-Surface-Trash-Collector/MotorPropeller Connections/CAD Models/U Joints/U Joint Final/U Joint.SLDASM

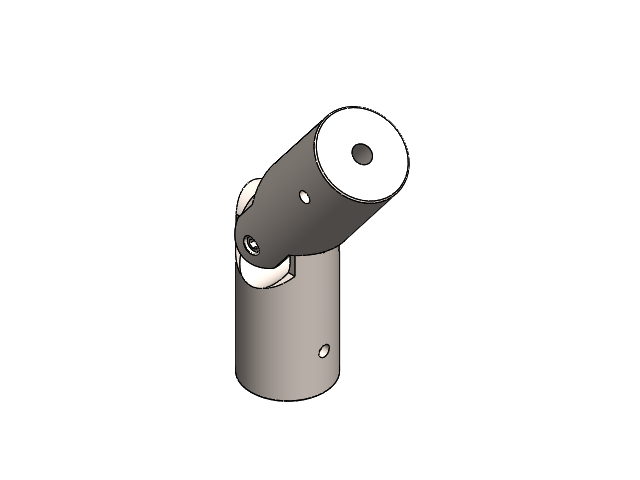
[picture p57: CAD file, 2024-11-22]
MotorPropeller Connections/CAD Models/U Joints/U Joint Final/U Joint.SLDASM
Joint B x 2
Plus
socket - fp_is x 4
