SriranganS/Water-Surface-Trash-Collector/CAD Model for Final Prototype/MotProp.SLDASM

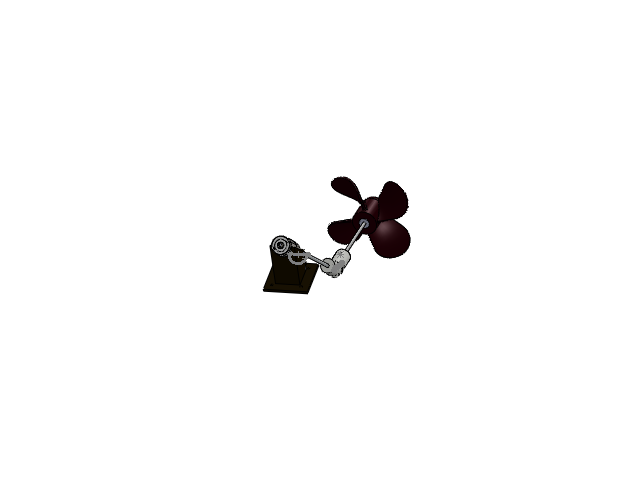
[picture p58: CAD file, 2024-11-22]
CAD Model for Final Prototype/MotProp.SLDASM
Part1^MotProp
ShaftLong
ShaftShort
Joint B x 2
Plus
socket - fp_is x 4
PropClos
Prop 1
mountmotor
Orange TT555 Rectangular gearbox DC motor (Motor Body).step
Orange OG555 High Torque DC Motor (Gear box).step
Orange OG555 High Torque DC Motor (Shaft).step
motormount_part2
