SriranganS/Water-Surface-Trash-Collector/CAD Model for Final Prototype/MotMou.SLDASM

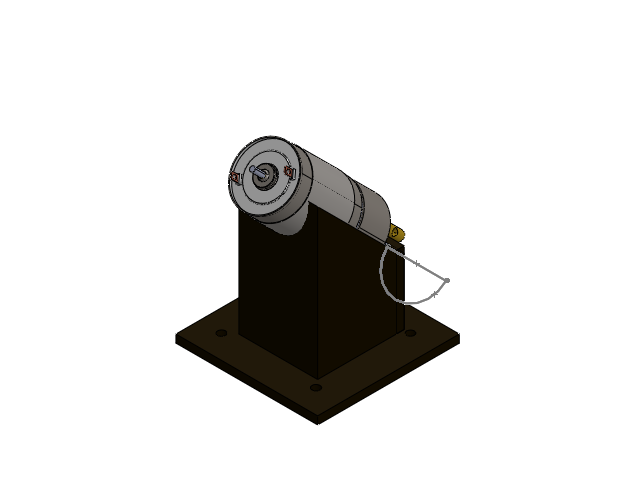
[picture p59: CAD file, 2024-11-22]
CAD Model for Final Prototype/MotMou.SLDASM
mountmotor
Orange TT555 Rectangular gearbox DC motor (Motor Body).step
Orange OG555 High Torque DC Motor (Gear box).step
Orange OG555 High Torque DC Motor (Shaft).step
motormount_part2
