SriranganS/Water-Surface-Trash-Collector/(list of files, cad)

Other CAD files:
Waterproofing Mechanism 1/RStand.STL
Updated Design/tefon dock.SLDPRT
MotorPropeller Connections/CAD Models/U Joints/U Joint Attempts/Pip.SLDPRT
Updated Design/TubeRight.SLDPRT
CAD Model for Final Prototype/platform.SLDPRT
CAD Model for Final Prototype/SelfMadeCoupler.SLDPRT
CAD Model for Final Prototype/plat.SLDPRT
CAD Model for Final Prototype/mountmotor.SLDPRT
CAD Model for Final Prototype/Prop 1.SLDPRT
CAD Model for Final Prototype/motormount_part2.SLDPRT
CAD Model for Final Prototype/Catch.SLDPRT
Design 4/Conveyer Belt.ipt
Design 4/Conveyer Boat.iam
Design 4/Ger.ipt
Design 4/Top Bin.ipt
Design 4/ranpro.ipt
Design 5/Design5.iam
Design 5/Distanced Top Bin.ipt
Design 5/Ger.ipt
Design 5/Layered Belt.ipt
Design 5/PVC.ipt
Design 5/ranpro.ipt
Initial Designs/Another.iam
Initial Designs/Assembly3.iam
Initial Designs/Base.ipt
Initial Designs/Constrained Boat.ipt
Initial Designs/Conveyer.ipt
Initial Designs/Dustbin Body.ipt
Initial Designs/Geear.ipt
Initial Designs/Ger_MIR.ipt
Initial Designs/H Gear.ipt
Initial Designs/Half Door.ipt
Initial Designs/Motor Shaft.ipt
Initial Designs/Roller.ipt
Initial Designs/TenAss1.iam
Initial Designs/Trap.ipt
Initial Designs/Volatile Boat.ipt
Initial Designs/ranpro_MIR.ipt
