SriranganS/Water-Surface-Trash-Collector/MotorPropeller Connections/Images/Assembled.jpg

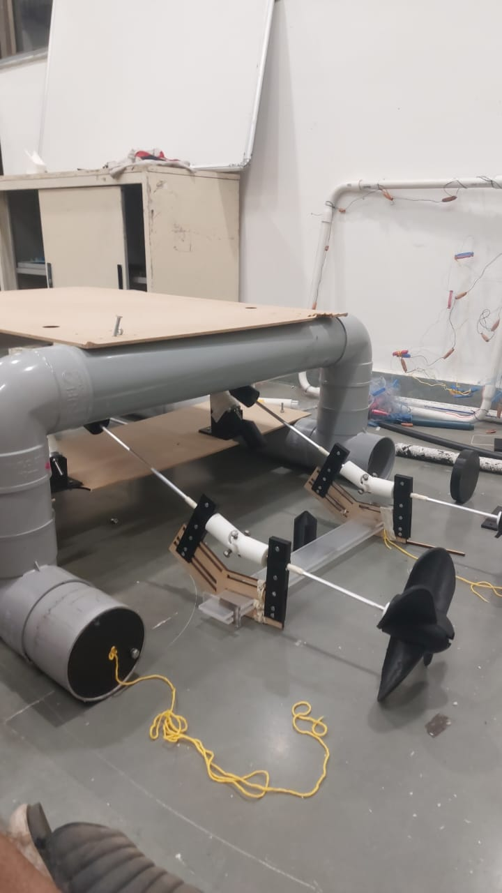
MotorPropeller Connections/Images/Assembled.jpg
