SriranganS/Water-Surface-Trash-Collector/U Joint Stabilisation/Assembly.jpg

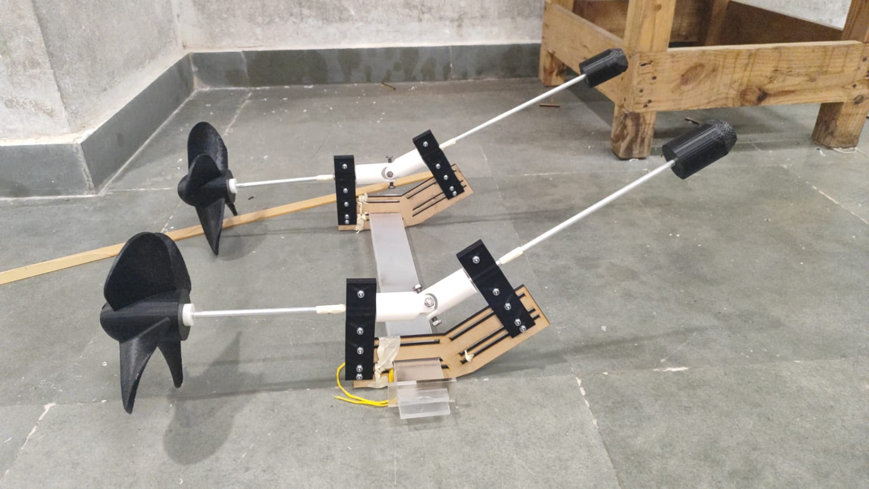
U Joint Stabilisation/Assembly.jpg
