SriranganS/Water-Surface-Trash-Collector/(commit log)

2024-09-14 Initial Designs and Calculations
    [Another.iam, Assembly3.iam, Base.ipt, Constrained Boat.ipt, Conveyer.ipt, Dustbin Body.ipt, Geear.ipt, Ger.ipt]
2024-09-18 Update new designs
    [Conveyer Belt.ipt, Conveyer Boat.iam, Design5.iam, Distanced Top Bin.ipt, Ger.ipt, Layered Belt.ipt, PVC.ipt, Top Bin.ipt]
2024-10-14 Added an updated version of the design
    [Conveyer Belt.SLDASM, FinalAssembly.SLDASM, MainBody.SLDASM, Motor.SLDPRT, Prop 1.SLDPRT, Shaft.SLDPRT, TubeLeft.SLDPRT, TubeRight.SLDPRT]
2024-11-22 Waterproofing Mechanism 1
    [LStand.STL, RStand.STL, gear.SLDPRT, gearupper.SLDPRT]
2024-11-22 Universal Joints
    [Joint B.SLDPRT, Plus.SLDPRT, U Joint.SLDASM, UJointcover.STL]
2024-11-22 Universal Joints Stabilisation
    [Catch.DXF, Catch.SLDPRT, Throw.SLDPRT]
2024-11-22 Motor-Propeller Assembly
    [ASSY_BERG_UJ3_U-JOINT_0250 SHAFT.sldasm, DoubCoup.STL, Joint B.SLDPRT, MotMou.SLDASM, MotProp.SLDASM, Motor.SLDPRT, NEMA17_Coupler.STL, Orient1.SLDASM]
2024-11-22 Final Prototype CAD
    [BackSeal - Copy.SLDPRT, Battery - Copy.SLDPRT, BottomPipe.SLDPRT, CameraMount.SLDPRT, Catch.SLDPRT, LowerMDF.SLDPRT, MDF.SLDPRT, MainBody.SLDASM]
